jellewie/Arduino-smart-home-switch/Schematic-PCB/V1.4 PCB.png

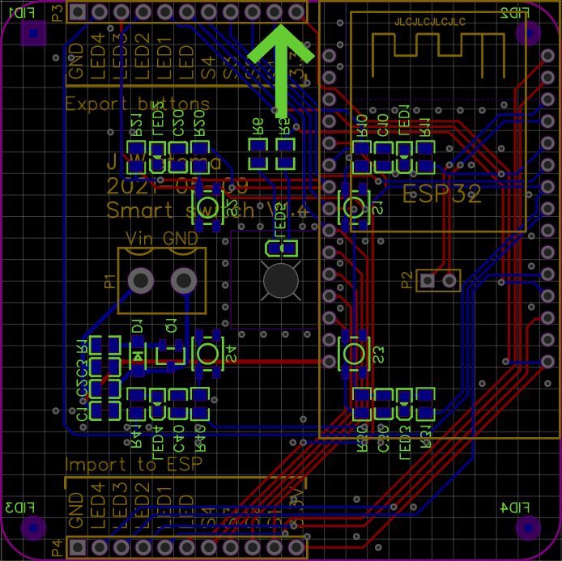
Schematic-PCB/V1.4 PCB.png
