jellewie/Arduino-smart-home-switch/3DModel/V4.2 In wall single.stl

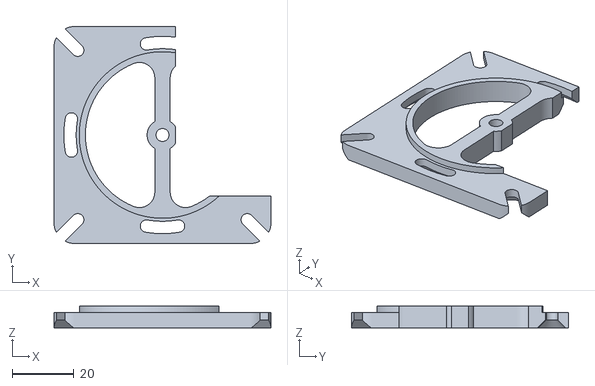
[picture p4: CAD file, 2021-05-02]
3DModel/V4.2 In wall single.stl
70.4 x 70.4 x 7.00
