jellewie/Arduino-smart-home-switch/3DModel/V4.2 Front Double.stl

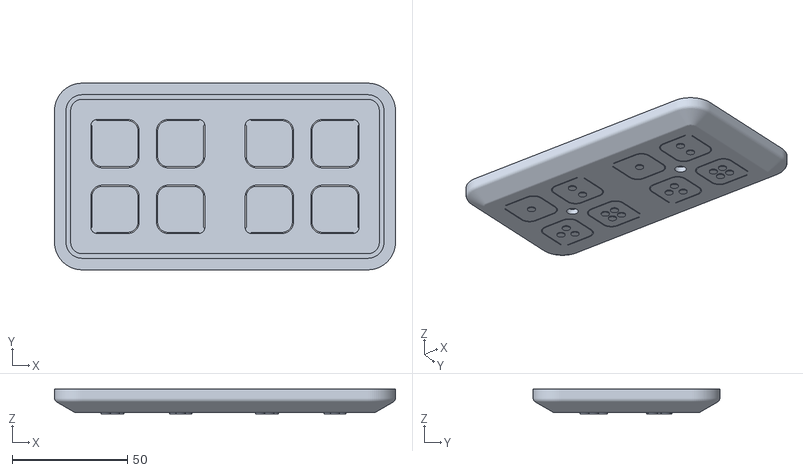
[picture p5: CAD file, 2021-05-02]
3DModel/V4.2 Front Double.stl
148.0 x 81.0 x 10.8
