jellewie/Arduino-smart-home-switch/3DModel/V4.2 Front Single.stl

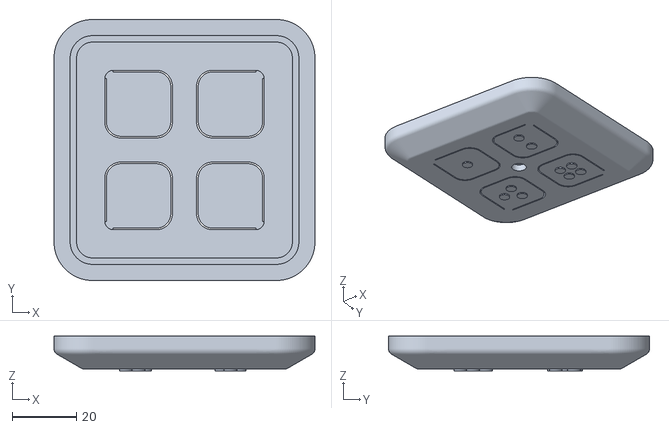
[picture p6: CAD file, 2021-05-02]
3DModel/V4.2 Front Single.stl
81.0 x 81.0 x 10.8
