jellewie/Arduino-smart-home-switch/3DModel/V4.2 In wall double.stl

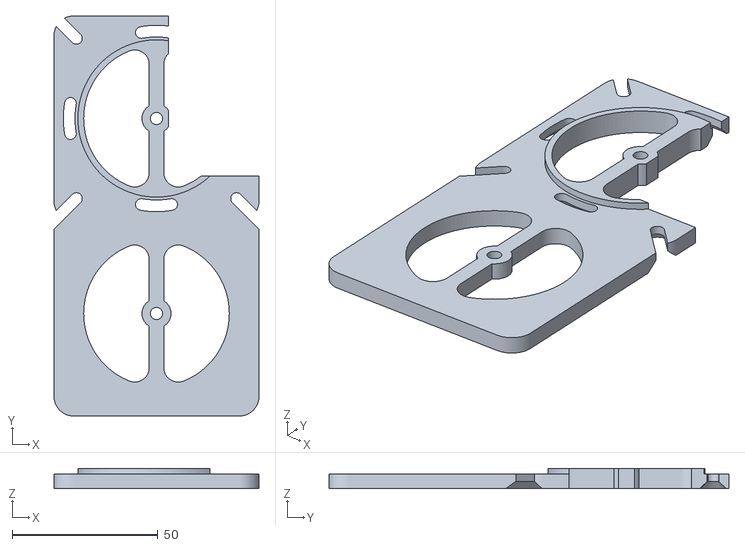
[picture p7: CAD file, 2021-05-02]
3DModel/V4.2 In wall double.stl
70.4 x 137.4 x 7.00
