jellewie/Arduino-smart-home-switch/(list of files, cad)

Other CAD files:
3DModel/V4.2 Assembly.iam
3DModel/V4.2 In wall.ipt
3DModel/V4.2 Plate dual.ipt
3DModel/V4.2 Plate single.ipt
