jellewie/Arduino-smart-home-switch/Schematic-PCB/V1.4 Schematic.pdf

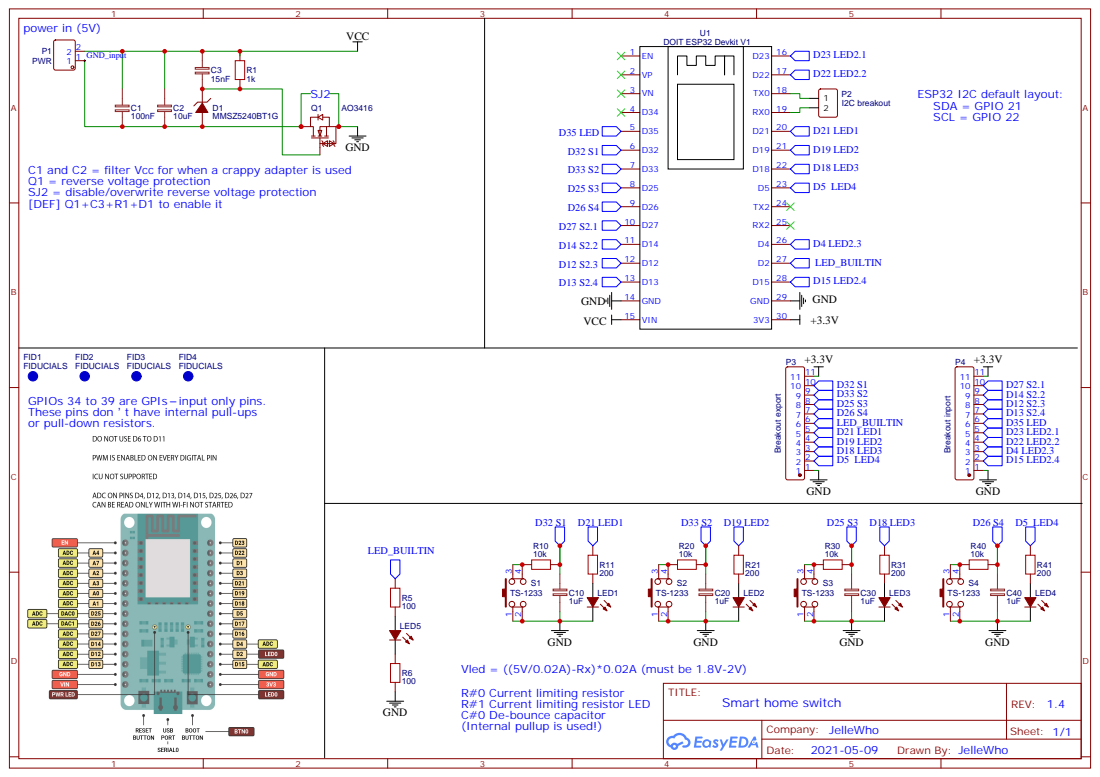
[picture p8: page 1]

C1 and C2 = filter Vcc for when a crappy adapter is used
Q1 = reverse voltage protection
SJ2 = disable/overwrite reverse voltage protection
[DEF] Q1+C3+R1+D1 to enable it

GPIOs 34 to 39 are GPIs input only pins.
These pins don t have internal pull-ups
or pull-down resistors.

Vled = ((5V/0.02A)-Rx)*0.02A (must be 1.8V-2V)
R#0 Current limiting resistor
R#1 Current limiting resistor LED
C#0 De-bounce capacitor
(Internal pullup is used!)
