jellewie/Arduino-smart-home-switch/PCB/2021-04-09 V1.3 Schematic.pdf

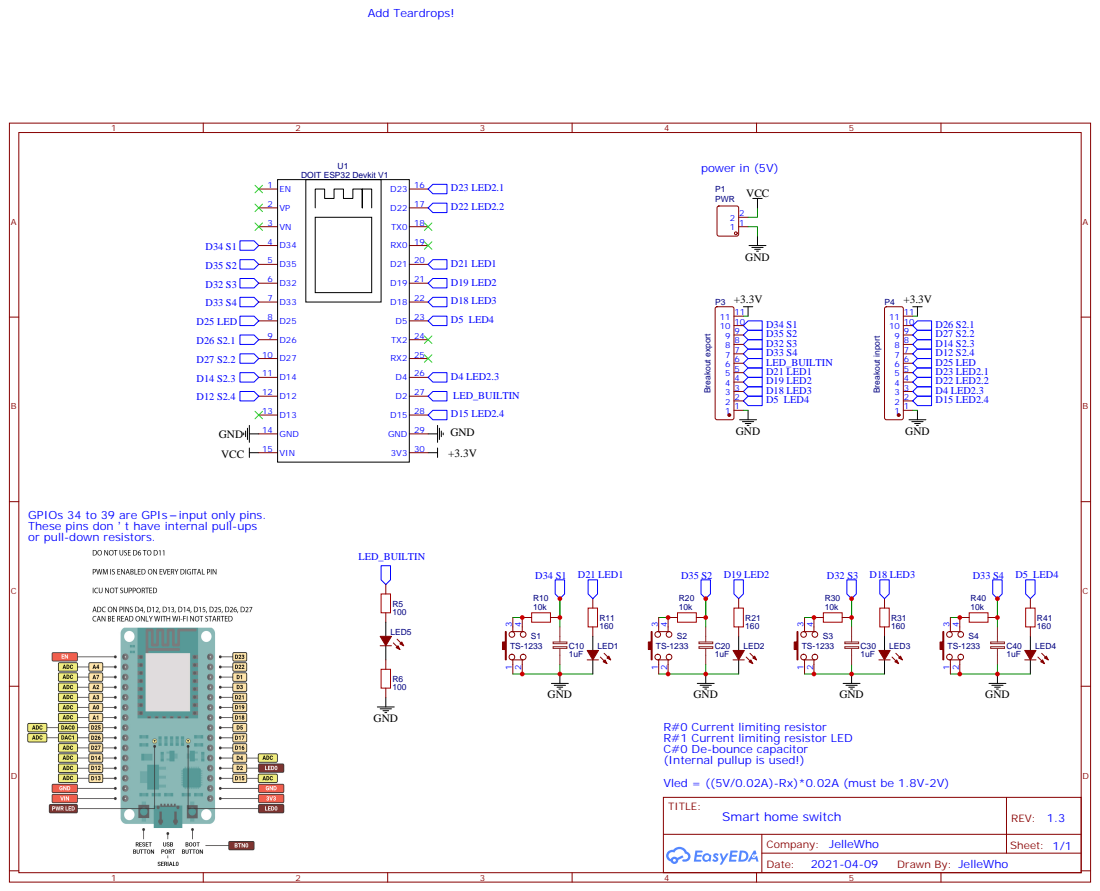
[picture p9: page 1]
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

R#0 Current limiting resistor
R#1 Current limiting resistor LED
C#0 De-bounce capacitor
(Internal pullup is used!)
Vled = ((5V/0.02A)-Rx)*0.02A (must be 1.8V-2V)
TITLE:
